tatjam/ionosphere_rx/todo.md

# Capacitor PCB

## Proof of concept

[X] ArduinoISP programmer breadboard tool
[ ] FSK generator tool (on the STM32 device for fast logic)
[ ] PLL demodulator
[ ] AtTiny software
    [ ] Relay driving (LEDs for demo)
    [ ] PLL demodulator RX
    [ ] DAC bitbang control 
    [ ] EEPROM? Probably simulate the EEPROM w/ a STM32 (for fast logic)
[ ] Dickson charge pump demo (at lower voltage, with BJT driver)

## Real construction

[ ] Finish designs with insights from POC
[ ] BOM review 
[ ] Pin and footprint review
[ ] Fabricate PCB
[ ] Assemble PCB

# Receiver PCB

## Proof of concept

[ ] Design amplifier in LTSpice
[ ] Implement with similar JFET and test

## Real construction

[ ] Design PCB
