tatjam/ionosphere_rx/journal/digital_10_received.png

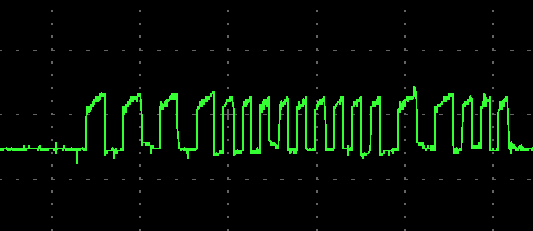
journal/digital_10_received.png
