tatjam/ionosphere_rx/hardware/capbank/capbank1.kicad_pcb

## KiCad design hardware/capbank/capbank1.kicad_pcb (2026-10-25)

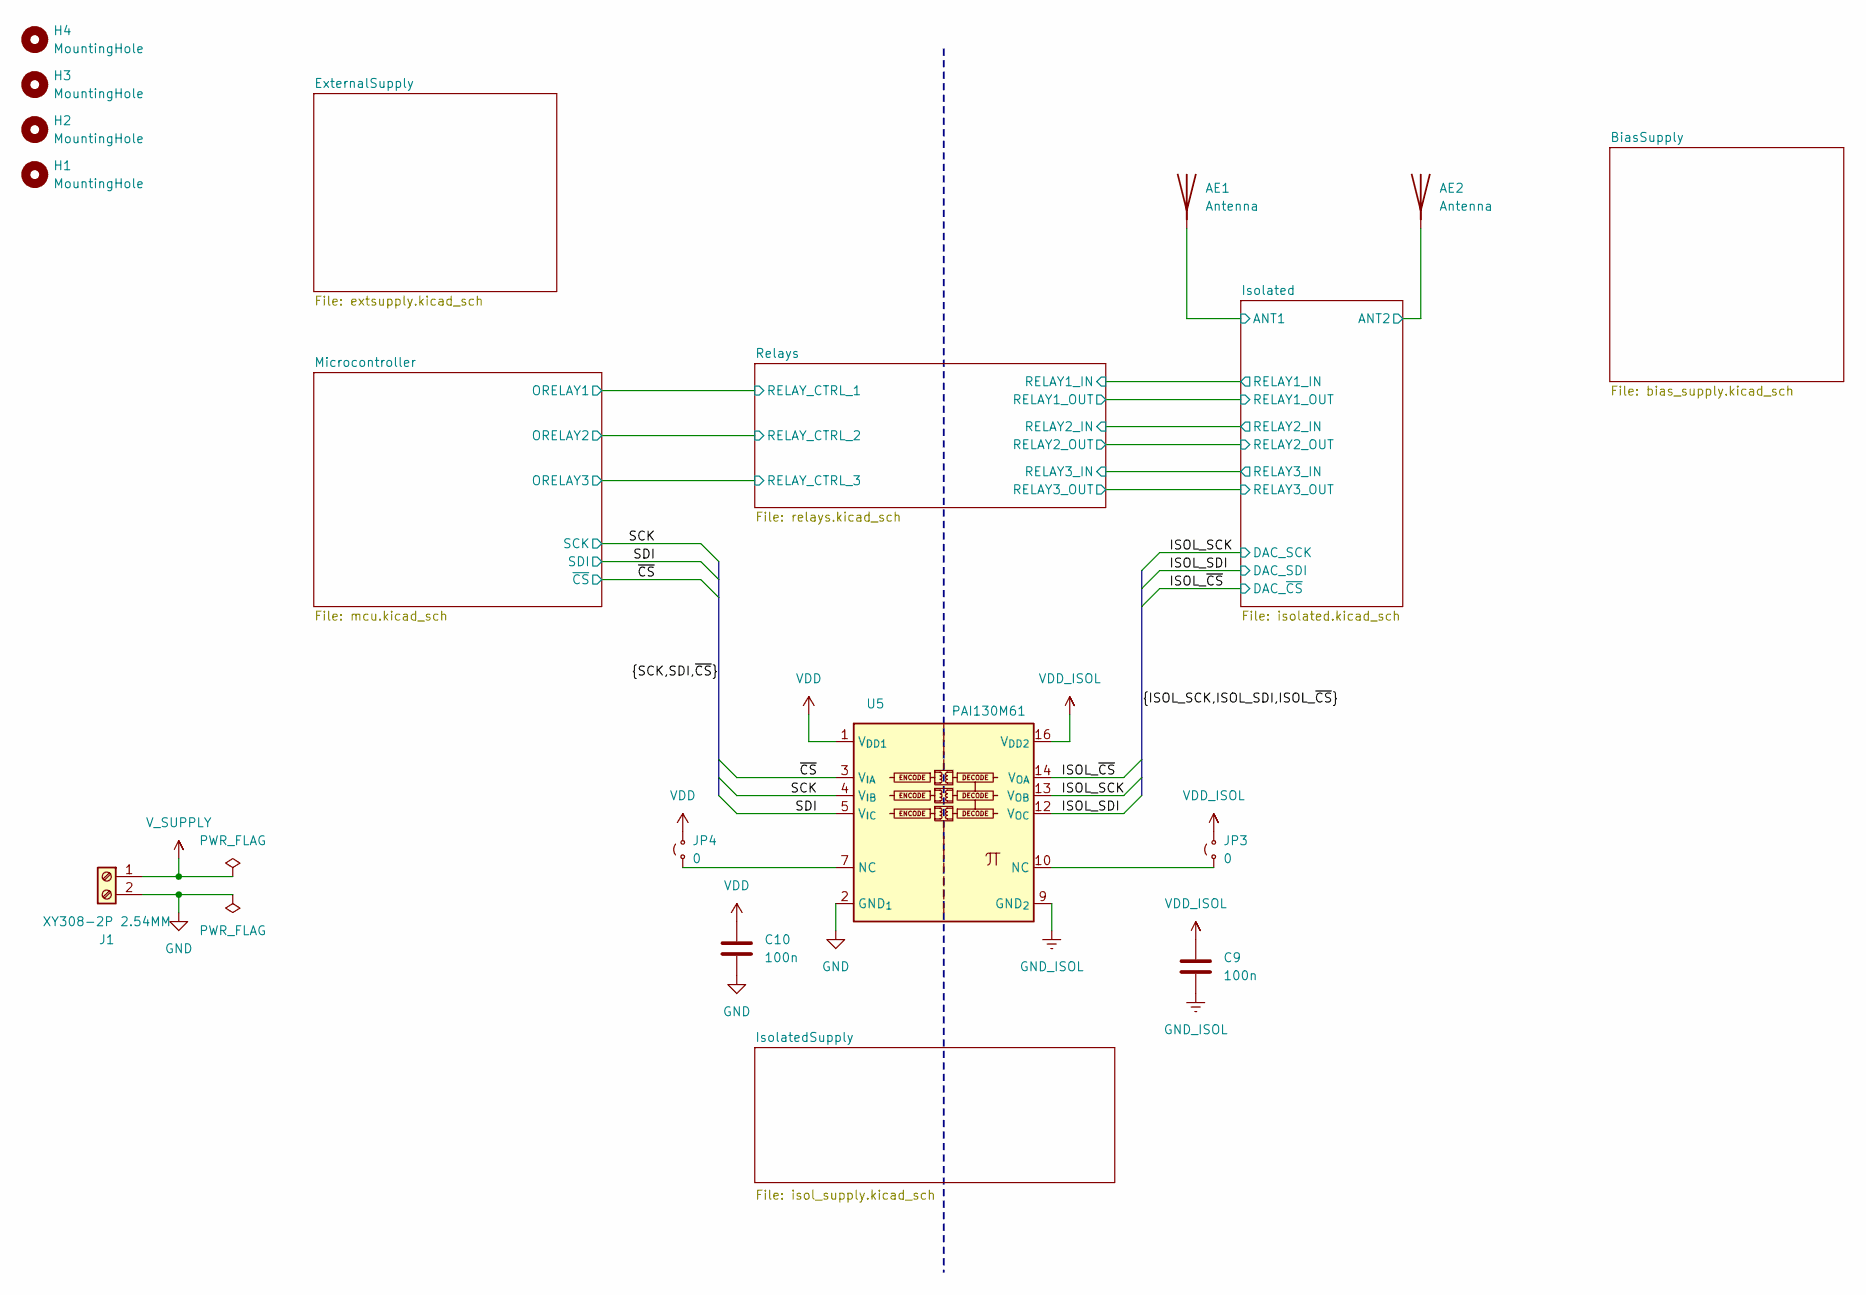
[picture p7: schematic capbank1.kicad_sch]

Parts:
AE1, AE2: Antenna; SolderWire-1.5sqmm_1x01_D1.7mm_OD3.9mm_Relief
C9, C10: 100n; C_0603_1608Metric
H1, H2, H3, H4: MountingHole; MountingHole_3.2mm_M3
J1: XY308-2P 2.54MM; TerminalBlock_Phoenix_MPT-0,5-2-2.54_1x02_P2.54mm_Horizontal
JP3, JP4: 0; R_0603_1608Metric
U5: PAI130M61; SOIC-16W_7.5x10.3mm_P1.27mm

Connections:
/ISOL_SCK: U5.13 (V_{OB}); also elsewhere on the board
/ISOL_SDI: U5.12 (V_{OC}); also elsewhere on the board
/ISOL_~CS: U5.14 (V_{OA}); also elsewhere on the board
/Isolated/ANT1: AE1.1 (A); also elsewhere on the board
/Isolated/ANT2: AE2.1 (A); also elsewhere on the board
/SCK: U5.4 (V_{IB}); also elsewhere on the board
/SDI: U5.5 (V_{IC}); also elsewhere on the board
/~CS: U5.3 (V_{IA}); also elsewhere on the board
GND: C10.2, J1.2, U5.2 (GND_{1}), U5.8 (GND_{1}); also elsewhere on the board
GND_ISOL: C9.2, U5.9 (GND_{2}), U5.15 (GND_{2}); also elsewhere on the board
unnamed: JP3.1 (A), U5.10 (NC)
unnamed: JP4.1 (A), U5.7 (NC)
VDD: C10.1, JP4.2 (B), U5.1 (V_{DD1}); also elsewhere on the board
VDD_ISOL: C9.1, JP3.2 (B), U5.16 (V_{DD2}); also elsewhere on the board
V_SUPPLY: J1.1; also elsewhere on the board

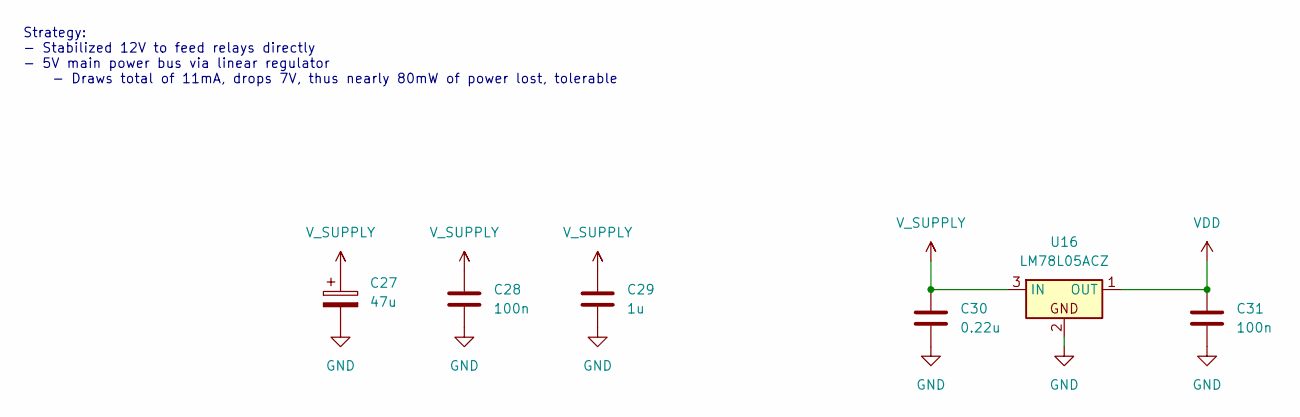
[picture p8: schematic extsupply.kicad_sch]

Parts:
C27: 47u; CP_Radial_D6.3mm_P2.50mm
C28, C31: 100n; C_0603_1608Metric
C29: 1u; C_0603_1608Metric
C30: 0.22u; C_0603_1608Metric
U16: LM78L05ACZ; TO-92_Inline_Wide

Connections:
GND: C27.2, C28.2, C29.2, C30.2, C31.2, U16.2; also elsewhere on the board
VDD: C31.1, U16.1 (OUT); also elsewhere on the board
V_SUPPLY: C27.1, C28.1, C29.1, C30.1, U16.3 (IN); also elsewhere on the board

Notes on the sheet:
Strategy: - Stabilized 12V to feed relays directly - 5V main power bus via linear regulator - Draws total of 11mA, drops 7V, thus nearly 80mW of power lost, tolerable

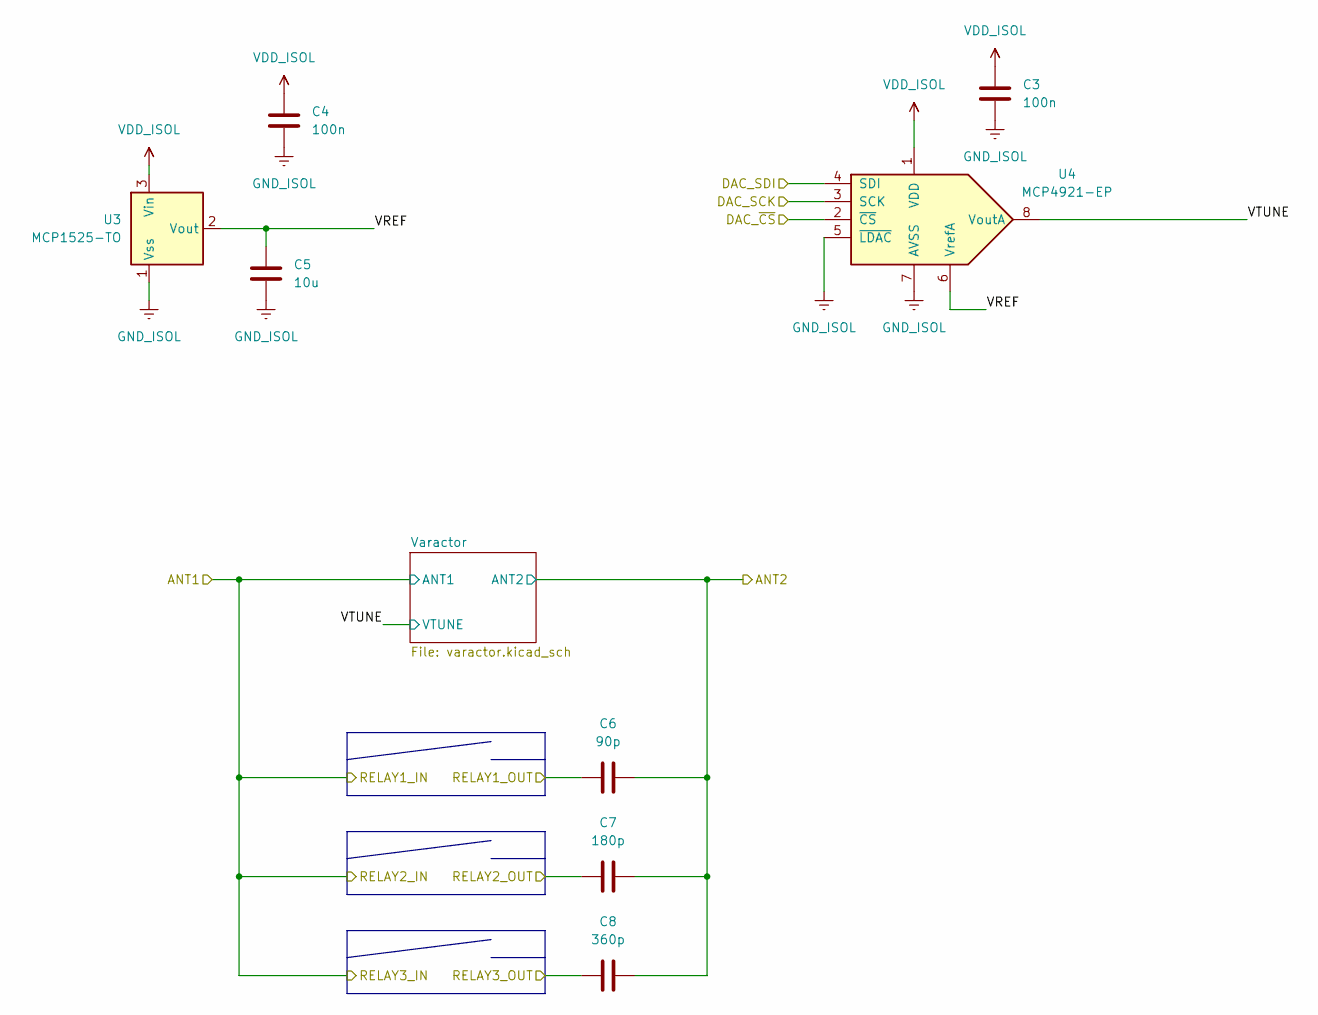
[picture p9: schematic isolated.kicad_sch]

Parts:
C3, C4: 100n; C_0603_1608Metric
C5: 10u; C_0603_1608Metric
C6: 90p; C_0603_1608Metric
C7: 180p; C_0603_1608Metric
C8: 360p; C_0603_1608Metric
U3: MCP1525-TO; TO-92_Inline
U4: MCP4921-EP; DIP-8_W7.62mm

Connections:
/ISOL_SCK: U4.3 (SCK); also elsewhere on the board
/ISOL_SDI: U4.4 (SDI); also elsewhere on the board
/ISOL_~CS: U4.2 (~CS); also elsewhere on the board
/Isolated/ANT2: C6.2, C7.2, C8.2; also elsewhere on the board
/Isolated/RELAY1_OUT: C6.1; also elsewhere on the board
/Isolated/RELAY2_OUT: C7.1; also elsewhere on the board
/Isolated/RELAY3_OUT: C8.1; also elsewhere on the board
/Isolated/VREF: C5.1, U3.2 (Vout), U4.6 (VrefA)
/Isolated/VTUNE: U4.8 (VoutA); also elsewhere on the board
GND_ISOL: C3.2, C4.2, C5.2, U3.1 (Vss), U4.5 (~LDAC), U4.7 (AVSS); also elsewhere on the board
VDD_ISOL: C3.1, C4.1, U3.3 (Vin), U4.1 (VDD); also elsewhere on the board

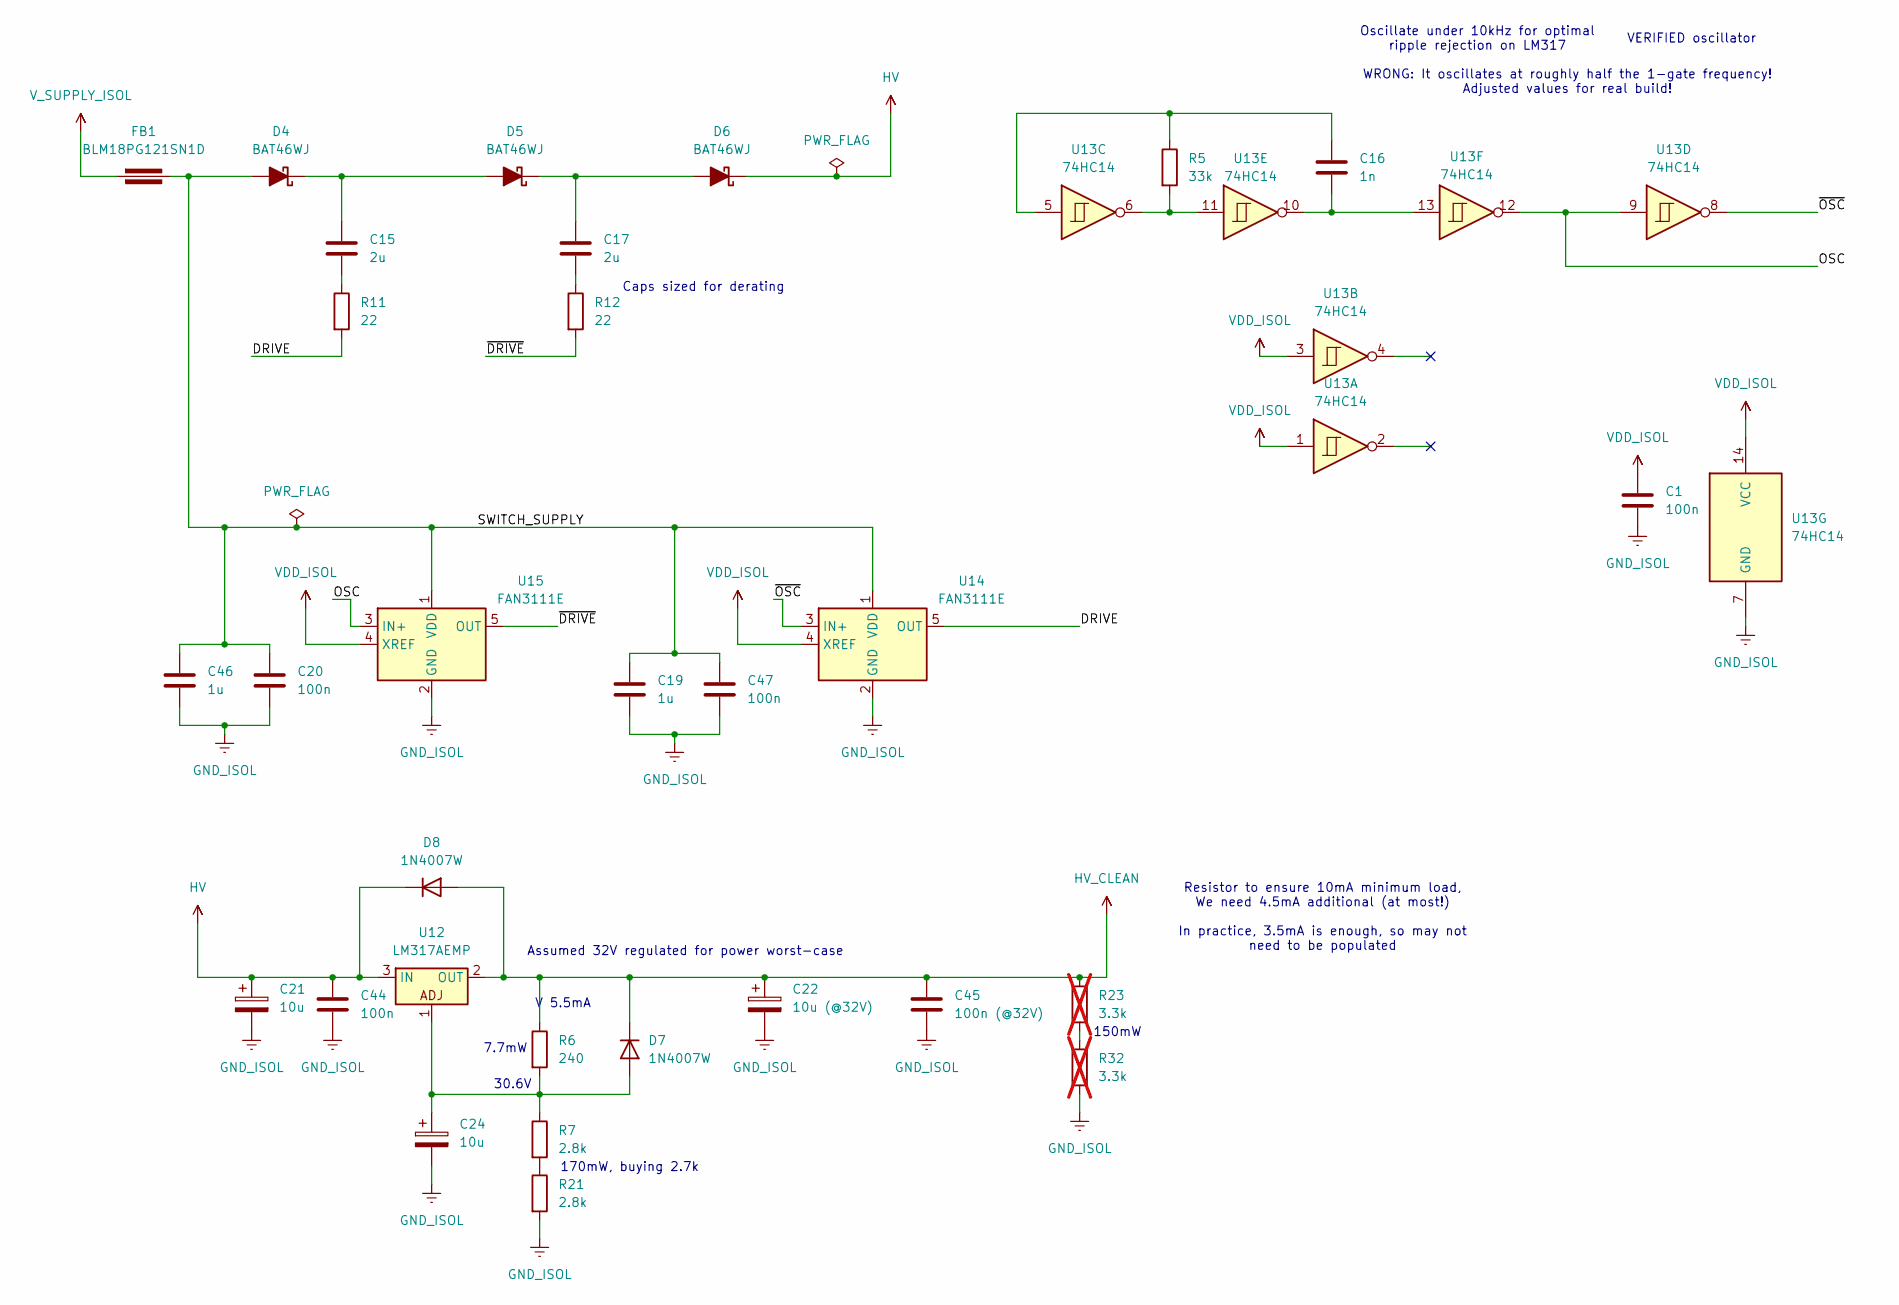
[picture p10: schematic bias_supply.kicad_sch]

Parts:
C1, C20, C44, C47: 100n; C_0603_1608Metric
C15, C17: 2u; C_0603_1608Metric
C16: 1n; C_0603_1608Metric
C19, C46: 1u; C_0603_1608Metric
C21, C24: 10u; CP_Radial_D5.0mm_P2.00mm
C22: 10u (@32V); CP_Radial_D5.0mm_P2.00mm
C45: 100n (@32V); C_0603_1608Metric
D4, D5, D6: BAT46WJ; D_SOD-323
D7, D8: 1N4007W; D_SOD-123
FB1: BLM18PG121SN1D; Ferrite_0603_1608Metric
R5: 33k; R_0603_1608Metric
R6: 240; R_0603_1608Metric
R7, R21: 2.8k; R_1206_3216Metric_Pad1.30x1.75mm_HandSolder
R11, R12: 22; R_0603_1608Metric
R23, R32: 3.3k; R_1206_3216Metric_Pad1.30x1.75mm_HandSolder; not fitted
U12: LM317AEMP; SOT-223-3_TabPin2
U13: 74HC14; SOIC-14_3.9x8.7mm_P1.27mm
U14, U15: FAN3111E; SOT-23-5

Connections:
/BiasSupply/DRIVE: R11.2, U14.5 (OUT)
/BiasSupply/OSC: U13.9, U13.12, U15.3 (IN+)
/BiasSupply/SWITCH_SUPPLY: C19.1, C20.1, C46.1, C47.1, D4.2 (A), FB1.2, U14.1 (VDD), U15.1 (VDD)
/BiasSupply/~DRIVE: R12.2, U15.5 (OUT)
/BiasSupply/~OSC: U13.8, U14.3 (IN+)
GND_ISOL: C1.2, C19.2, C20.2, C21.2, C22.2, C24.2, C44.2, C45.2, C46.2, C47.2, R21.2, R32.2, U13.7 (GND), U14.2 (GND), U15.2 (GND); also elsewhere on the board
HV: C21.1, C44.1, D6.1 (K), D8.1 (K), U12.3 (IN)
HV_CLEAN: C22.1, C45.1, D7.1 (K), D8.2 (A), R6.1, R23.1, U12.2 (OUT); also elsewhere on the board
unnamed: C15.2, R11.1
unnamed: C16.1, R5.1, U13.5
unnamed: C16.2, U13.10, U13.13
unnamed: C17.2, R12.1
unnamed: C15.1, D4.1 (K), D5.2 (A)
unnamed: C17.1, D5.1 (K), D6.2 (A)
unnamed: C24.1, D7.2 (A), R6.2, R7.1, U12.1
unnamed: R5.2, U13.6, U13.11
unnamed: R7.2, R21.1
unnamed: R23.2, R32.1
VDD_ISOL: C1.1, U13.1, U13.3, U13.14 (VCC), U14.4 (XREF), U15.4 (XREF); also elsewhere on the board
V_SUPPLY_ISOL: FB1.1; also elsewhere on the board

Notes on the sheet:
WRONG: It oscillates at roughly half the 1-gate frequency! Adjusted values for real build!
VERIFIED oscillator
30.6V
150mW
Oscillate under 10kHz for optimal ripple rejection on LM317
Assumed 32V regulated for power worst-case
7.7mW
Resistor to ensure 10mA minimum load, We need 4.5mA additional (at most!) In practice, 3.5mA is enough, so may not need to be populated
170mW, buying 2.7k
V 5.5mA
Caps sized for derating

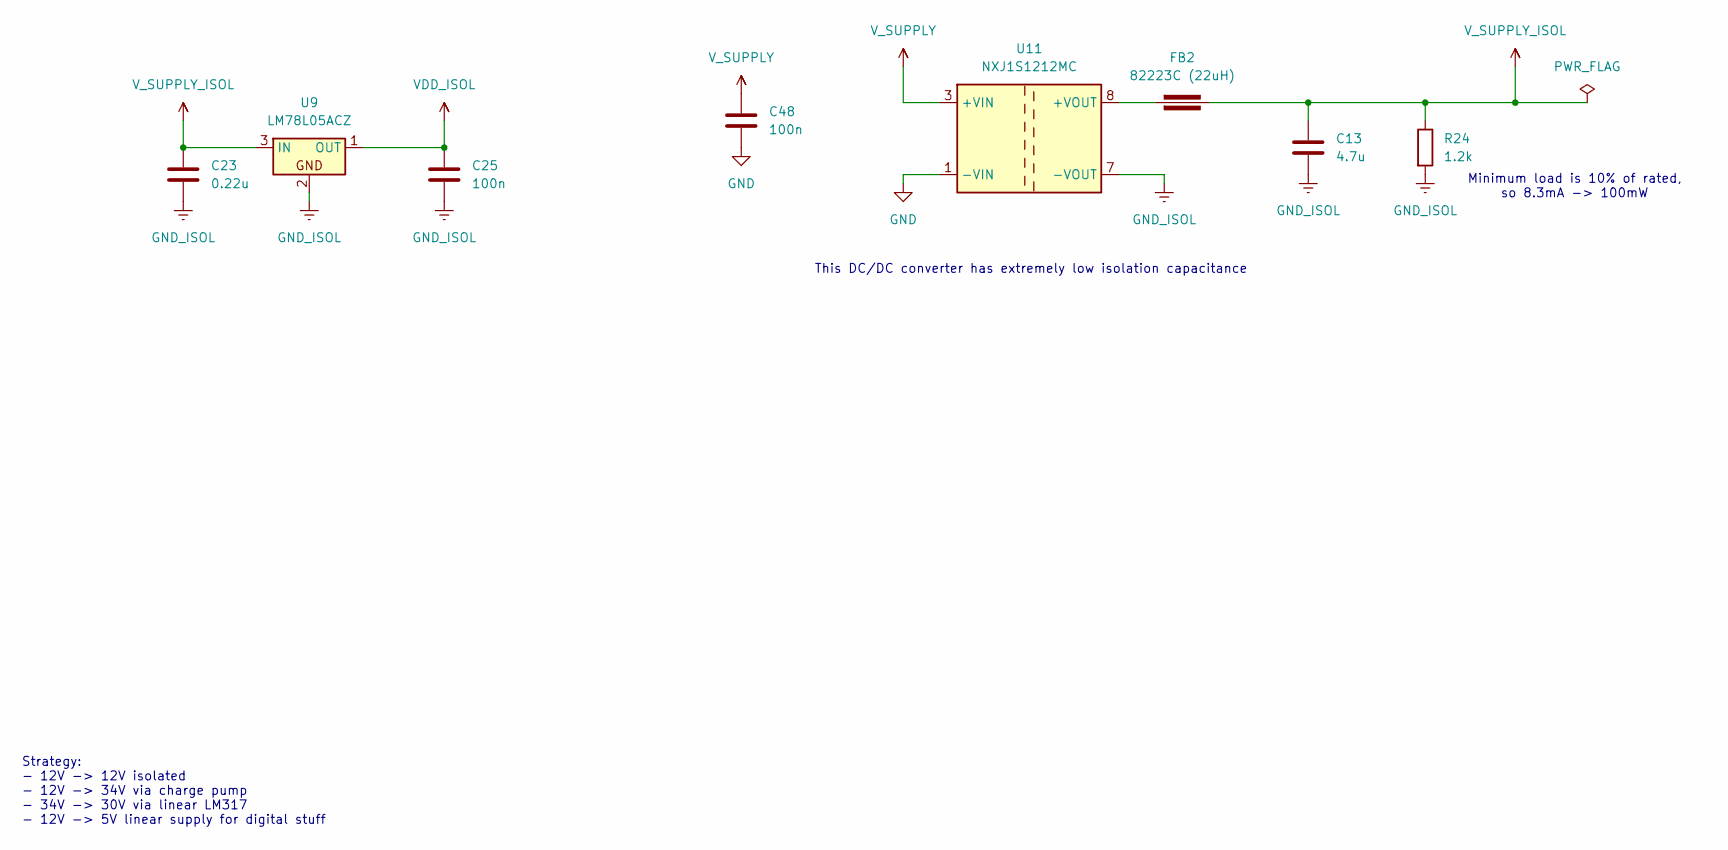
[picture p11: schematic isol_supply.kicad_sch]

Parts:
C13: 4.7u; C_1210_3225Metric_Pad1.33x2.70mm_HandSolder
C23: 0.22u; C_0603_1608Metric
C25, C48: 100n; C_0603_1608Metric
FB2: 82223C (22uH); 82223C
R24: 1.2k; R_1206_3216Metric_Pad1.30x1.75mm_HandSolder
U9: LM78L05ACZ; TO-92_Inline_Wide
U11: NXJ1S1212MC; NXJ1

Connections:
GND: C48.2, U11.1 (-VIN); also elsewhere on the board
GND_ISOL: C13.2, C23.2, C25.2, R24.2, U9.2, U11.7 (-VOUT); also elsewhere on the board
unnamed: FB2.1, U11.8 (+VOUT)
VDD_ISOL: C25.1, U9.1 (OUT); also elsewhere on the board
V_SUPPLY: C48.1, U11.3 (+VIN); also elsewhere on the board
V_SUPPLY_ISOL: C13.1, C23.1, FB2.2, R24.1, U9.3 (IN); also elsewhere on the board

Notes on the sheet:
Strategy: - 12V -> 12V isolated - 12V -> 34V via charge pump - 34V -> 30V via linear LM317 - 12V -> 5V linear supply for digital stuff
Minimum load is 10% of rated, so 8.3mA -> 100mW
This DC/DC converter has extremely low isolation capacitance

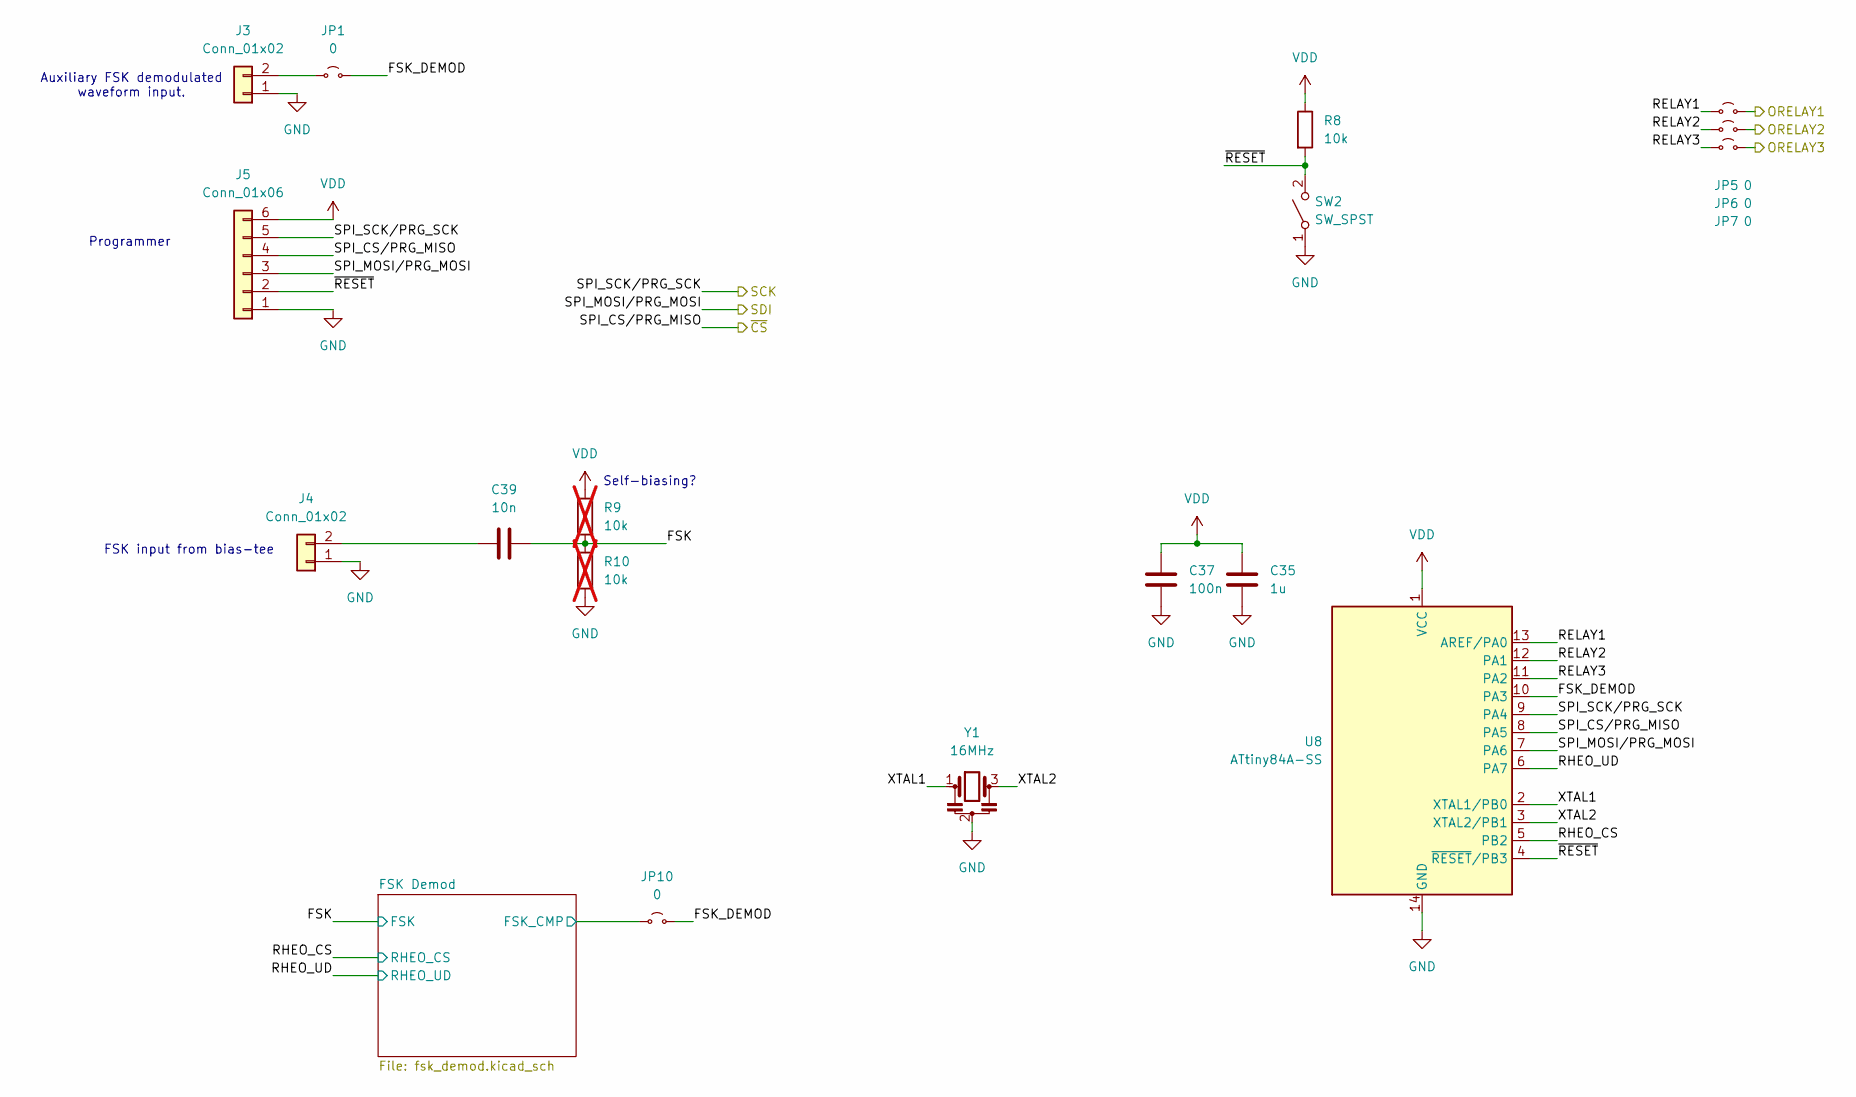
[picture p12: schematic mcu.kicad_sch]

Parts:
C35: 1u; C_0603_1608Metric
C37: 100n; C_0603_1608Metric
C39: 10n; C_0603_1608Metric
J3, J4: Conn_01x02; PinHeader_1x02_P2.54mm_Vertical
J5: Conn_01x06
JP1, JP5, JP6, JP7, JP10: 0; R_0603_1608Metric
R8: 10k; R_0603_1608Metric
R9, R10: 10k; R_0603_1608Metric; not fitted
SW2: SW_SPST; SW_SPST_CK_KXT3
U8: ATtiny84A-SS; SOIC-14_3.9x8.7mm_P1.27mm
Y1: 16MHz; Resonator_SMD_muRata_CSTxExxV-3Pin_3.0x1.1mm_BigPads

Connections:
/Microcontroller/FSK: C39.2, R9.2, R10.1; also elsewhere on the board
/Microcontroller/FSK Demod/FSK_CMP: JP10.1 (A); also elsewhere on the board
/Microcontroller/FSK_DEMOD: JP1.2 (B), JP10.2 (B), U8.10 (PA3)
/Microcontroller/ORELAY1: JP5.2 (B); also elsewhere on the board
/Microcontroller/ORELAY2: JP6.2 (B); also elsewhere on the board
/Microcontroller/ORELAY3: JP7.2 (B); also elsewhere on the board
/Microcontroller/RELAY1: JP5.1 (A), U8.13 (AREF/PA0)
/Microcontroller/RELAY2: JP6.1 (A), U8.12 (PA1)
/Microcontroller/RELAY3: JP7.1 (A), U8.11 (PA2)
/Microcontroller/RHEO_CS: U8.5 (PB2); also elsewhere on the board
/Microcontroller/RHEO_UD: U8.6 (PA7); also elsewhere on the board
/Microcontroller/XTAL1: U8.2 (XTAL1/PB0), Y1.1
/Microcontroller/XTAL2: U8.3 (XTAL2/PB1), Y1.3
/Microcontroller/~RESET: J5.2, R8.2, SW2.2 (B), U8.4 (~RESET/PB3)
/SCK: J5.5, U8.9 (PA4); also elsewhere on the board
/SDI: J5.3, U8.7 (PA6); also elsewhere on the board
/~CS: J5.4, U8.8 (PA5); also elsewhere on the board
GND: C35.2, C37.2, J3.1, J4.1, J5.1, R10.2, SW2.1 (A), U8.14 (GND), Y1.2; also elsewhere on the board
unnamed: J3.2, JP1.1 (A)
unnamed: C39.1, J4.2
VDD: C35.1, C37.1, J5.6, R8.1, R9.1, U8.1 (VCC); also elsewhere on the board

Notes on the sheet:
Programmer
Auxiliary FSK demodulated waveform input.
Self-biasing?
FSK input from bias-tee

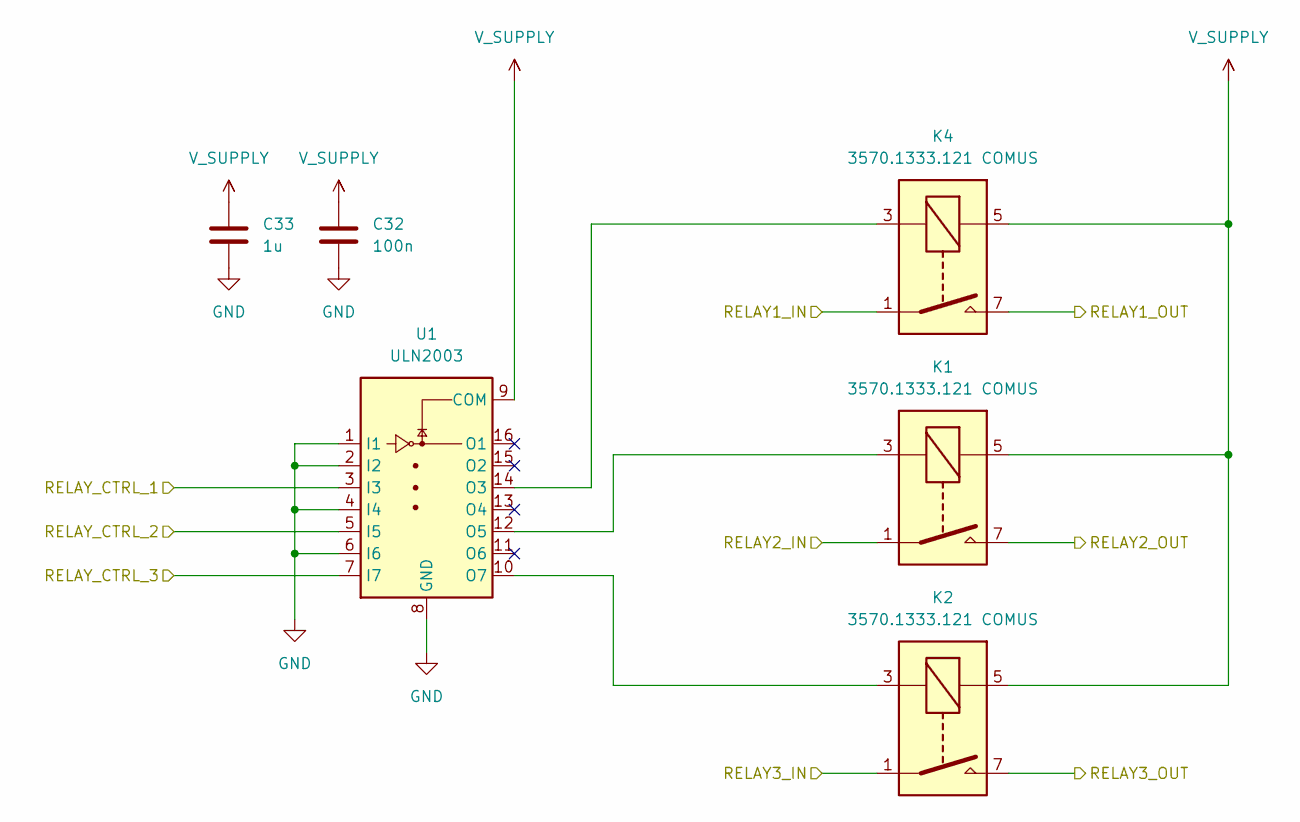
[picture p13: schematic relays.kicad_sch]

Parts:
C32: 100n; C_0603_1608Metric
C33: 1u; C_0603_1608Metric
K1, K2, K4: 3570.1333.121 COMUS; Relay_SPST_StandexMeder_SIL_Form1A
U1: ULN2003; SOIC-16_3.9x9.9mm_P1.27mm

Connections:
/Isolated/ANT1: K1.1, K2.1, K4.1; also elsewhere on the board
/Isolated/RELAY1_OUT: K4.7; also elsewhere on the board
/Isolated/RELAY2_OUT: K1.7; also elsewhere on the board
/Isolated/RELAY3_OUT: K2.7; also elsewhere on the board
/Microcontroller/ORELAY1: U1.3 (I3); also elsewhere on the board
/Microcontroller/ORELAY2: U1.5 (I5); also elsewhere on the board
/Microcontroller/ORELAY3: U1.7 (I7); also elsewhere on the board
GND: C32.2, C33.2, U1.1 (I1), U1.2 (I2), U1.4 (I4), U1.6 (I6), U1.8 (GND); also elsewhere on the board
unnamed: K4.3, U1.14 (O3)
unnamed: K1.3, U1.12 (O5)
unnamed: K2.3, U1.10 (O7)
V_SUPPLY: C32.1, C33.1, K1.5, K2.5, K4.5, U1.9 (COM); also elsewhere on the board

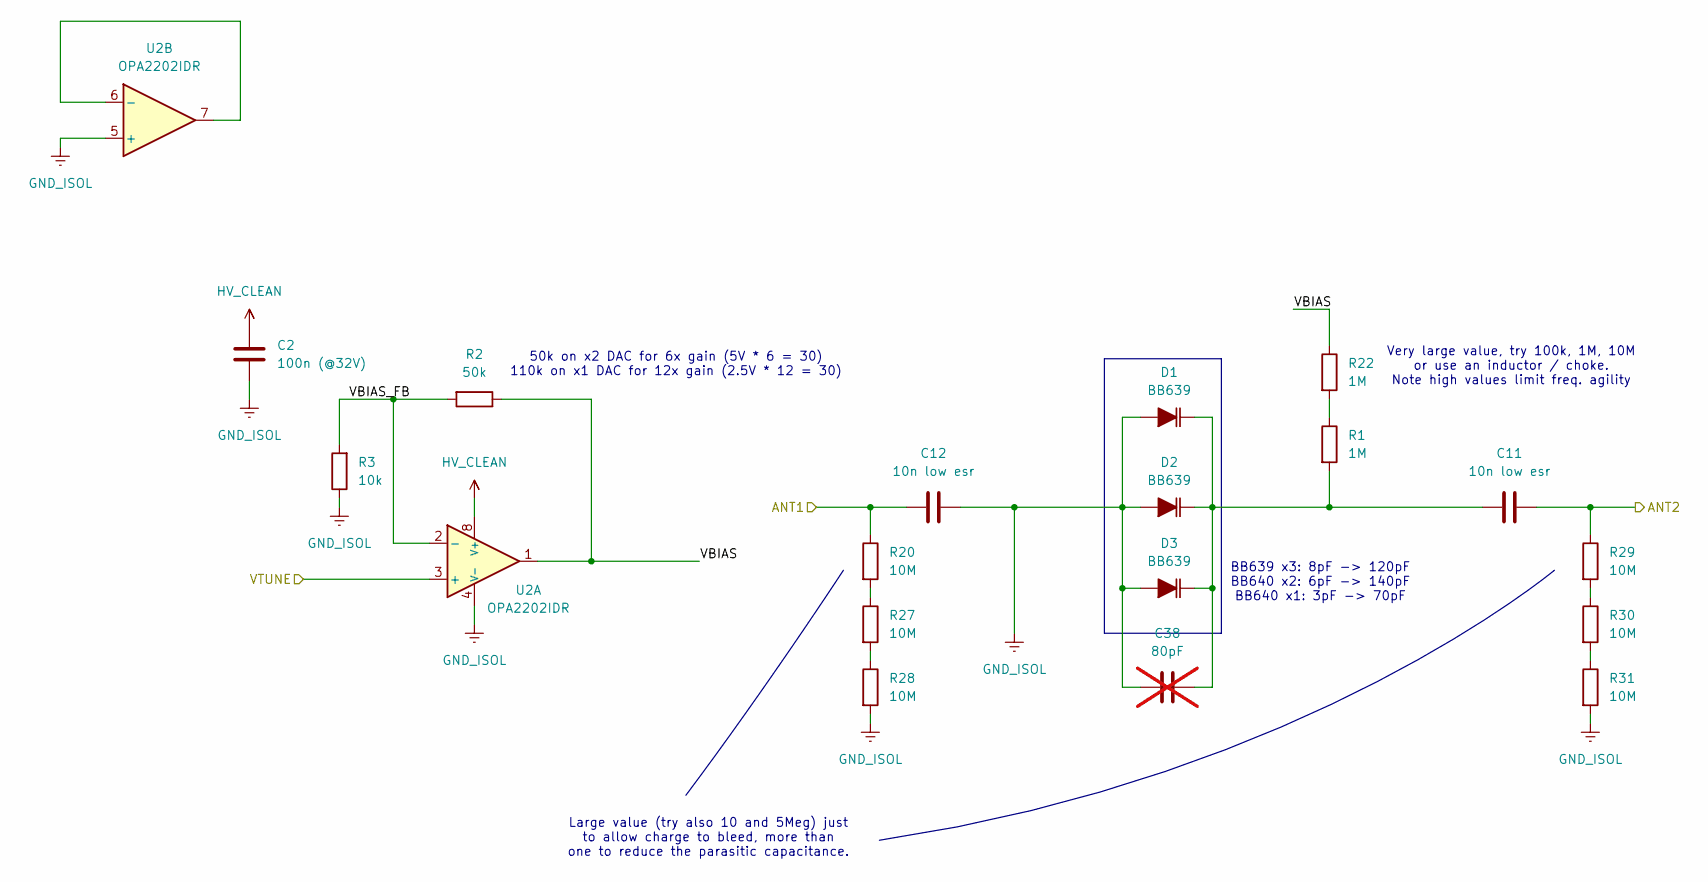
[picture p14: schematic varactor.kicad_sch]

Parts:
C2: 100n (@32V); C_0603_1608Metric
C11, C12: 10n low esr; C_1206_3216Metric
C38: 80pF; C_0603_1608Metric; not fitted
D1, D2, D3: BB639; D_SOD-323
R1, R22: 1M; R_0603_1608Metric
R2: 50k; R_0603_1608Metric
R3: 10k; R_0603_1608Metric
R20, R27, R28, R29, R30, R31: 10M; R_0603_1608Metric
U2: OPA2202IDR; SOIC-8_3.9x4.9mm_P1.27mm

Connections:
/Isolated/ANT1: C12.1, R20.1; also elsewhere on the board
/Isolated/ANT2: C11.2, R29.1; also elsewhere on the board
/Isolated/VTUNE: U2.3 (+); also elsewhere on the board
/Isolated/Varactor/VBIAS: R2.1, R22.1, U2.1
/Isolated/Varactor/VBIAS_FB: R2.2, R3.2, U2.2 (-)
GND_ISOL: C2.2, C12.2, C38.1, D1.2 (A), D2.2 (A), D3.2 (A), R3.1, R28.2, R31.2, U2.4 (V-), U2.5 (+); also elsewhere on the board
HV_CLEAN: C2.1, U2.8 (V+); also elsewhere on the board
unnamed: C11.1, C38.2, D1.1 (K), D2.1 (K), D3.1 (K), R1.2
unnamed: R1.1, R22.2
unnamed: R20.2, R27.1
unnamed: R27.2, R28.1
unnamed: R29.2, R30.1
unnamed: R30.2, R31.1
unnamed: U2.6 (-), U2.7

Notes on the sheet:
Large value (try also 10 and 5Meg) just to allow charge to bleed, more than one to reduce the parasitic capacitance.
50k on x2 DAC for 6x gain (5V * 6 = 30) 110k on x1 DAC for 12x gain (2.5V * 12 = 30)
BB639 x3: 8pF -> 120pF BB640 x2: 6pF -> 140pF BB640 x1: 3pF -> 70pF
Very large value, try 100k, 1M, 10M or use an inductor / choke. Note high values limit freq. agility

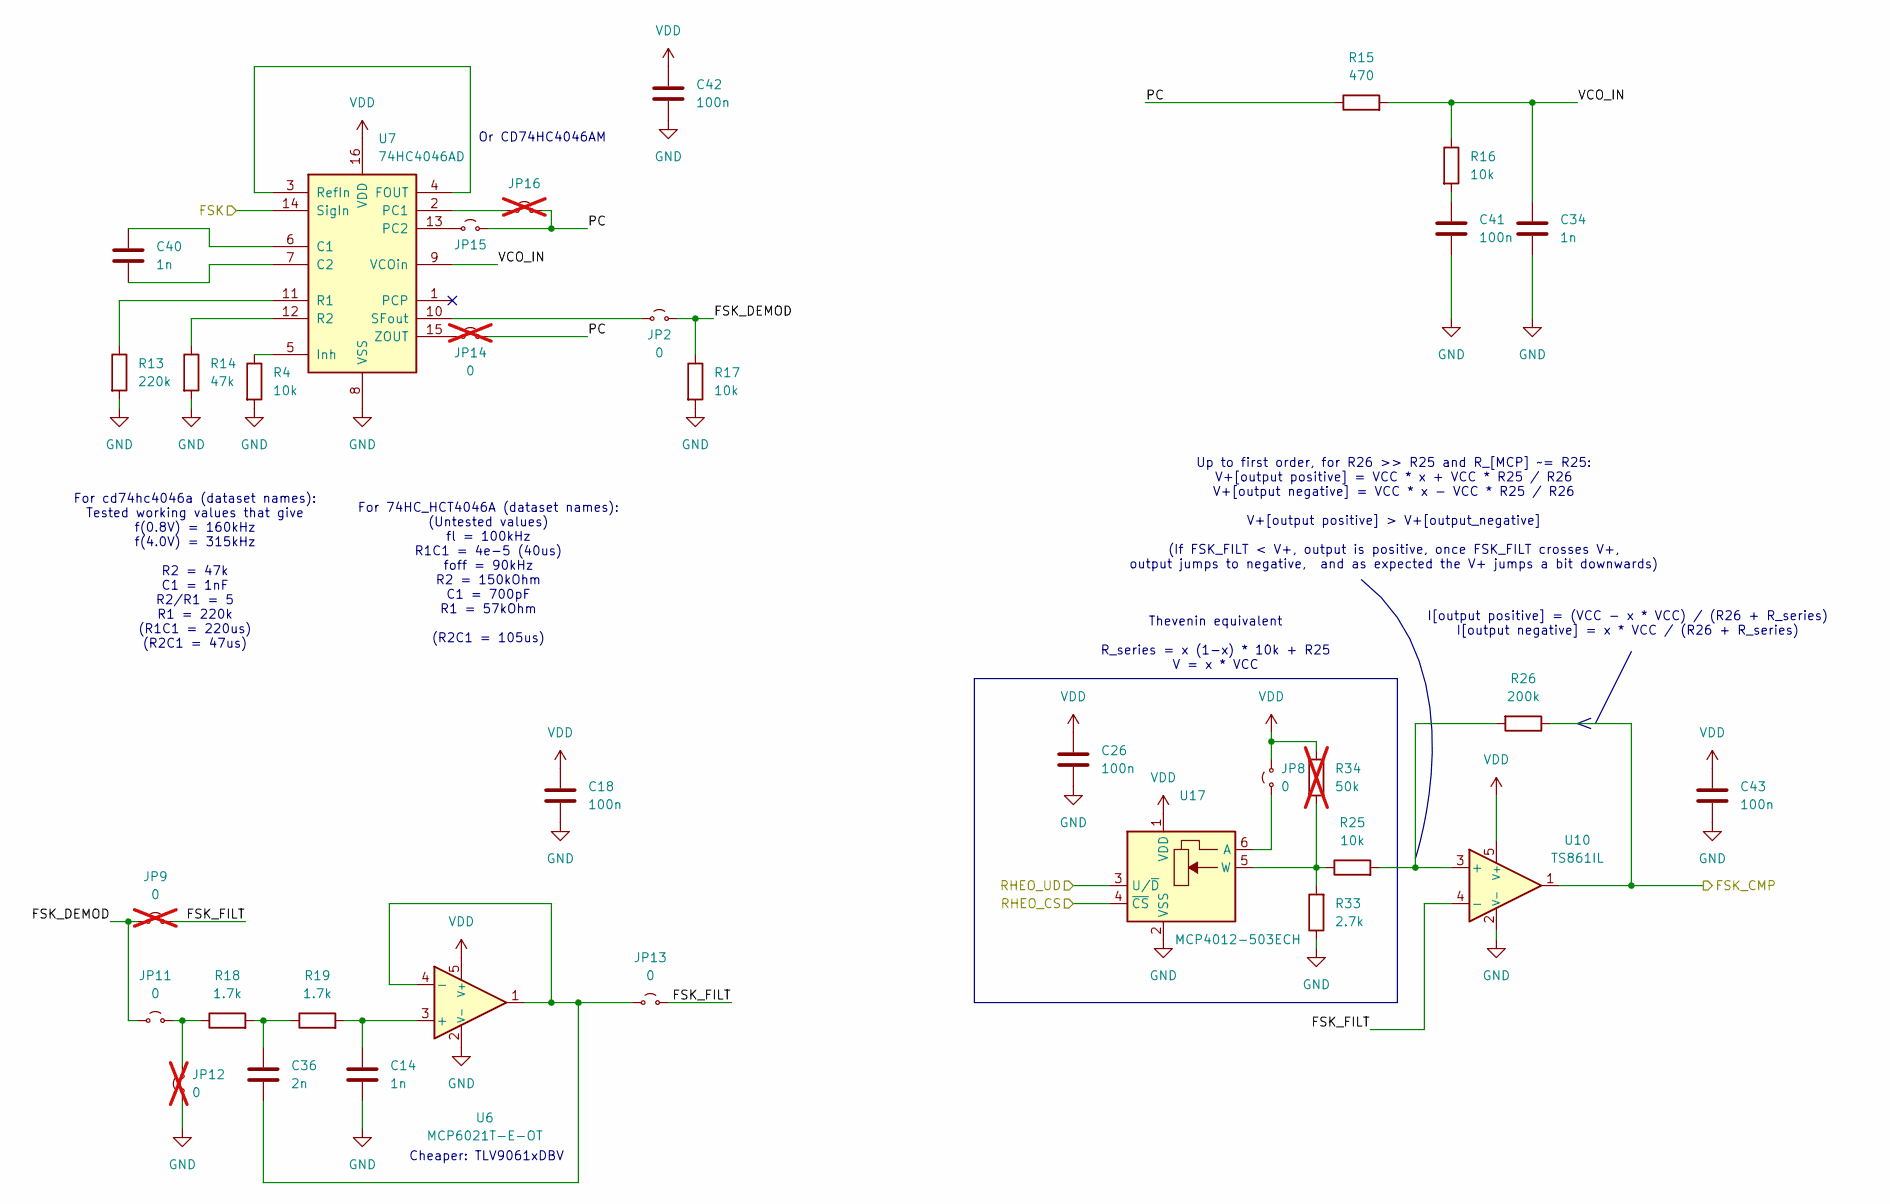
[picture p15: schematic fsk_demod.kicad_sch]

Parts:
C14, C34, C40: 1n; C_0603_1608Metric
C18, C26, C41, C42, C43: 100n; C_0603_1608Metric
C36: 2n; C_0603_1608Metric
JP2, JP8, JP11, JP13, JP15: 0; R_0603_1608Metric
JP9, JP12, JP14, JP16: 0; R_0603_1608Metric; not fitted
R4, R16, R17, R25: 10k; R_0603_1608Metric
R13: 220k; R_0603_1608Metric
R14: 47k; R_0603_1608Metric
R15: 470; R_0603_1608Metric
R18, R19: 1.7k; R_0603_1608Metric
R26: 200k; R_0603_1608Metric
R33: 2.7k; R_0603_1608Metric
R34: 50k; R_0603_1608Metric; not fitted
U6: MCP6021T-E-OT; SOT-23-5
U7: 74HC4046AD; SOIC-16_3.9x9.9mm_P1.27mm
U10: TS861IL; SOT-23-5
U17: MCP4012-503ECH; SOT-23-6

Connections:
/Microcontroller/FSK: U7.14 (SigIn); also elsewhere on the board
/Microcontroller/FSK Demod/FSK_CMP: R26.1, U10.1; also elsewhere on the board
/Microcontroller/FSK Demod/FSK_DEMOD: JP2.2 (B), JP9.1 (A), JP11.1 (A), R17.1
/Microcontroller/FSK Demod/FSK_FILT: JP9.2 (B), JP13.2 (B), U10.4 (-)
/Microcontroller/FSK Demod/PC: JP14.2 (B), JP15.2 (B), JP16.2 (B), R15.1
/Microcontroller/FSK Demod/VCO_IN: C34.1, R15.2, R16.1, U7.9 (VCOin)
/Microcontroller/RHEO_CS: U17.4 (~CS); also elsewhere on the board
/Microcontroller/RHEO_UD: U17.3 (U/~D); also elsewhere on the board
GND: C14.2, C18.2, C26.2, C34.2, C41.2, C42.2, C43.2, JP12.1 (A), R4.2, R13.2, R14.2, R17.2, R33.1, U6.2 (V-), U7.8 (VSS), U10.2 (V-), U17.2 (VSS); also elsewhere on the board
unnamed: C36.1, R18.2, R19.1
unnamed: C41.1, R16.2
unnamed: JP2.1 (A), U7.10 (SFout)
unnamed: JP8.1 (A), U17.6 (A)
unnamed: JP11.2 (B), JP12.2 (B), R18.1
unnamed: C36.2, JP13.1 (A), U6.1, U6.4 (-)
unnamed: JP14.1 (A), U7.15 (ZOUT)
unnamed: JP15.1 (A), U7.13 (PC2)
unnamed: JP16.1 (A), U7.2 (PC1)
unnamed: C14.1, R19.2, U6.3 (+)
unnamed: C40.1, U7.6 (C1)
unnamed: C40.2, U7.7 (C2)
unnamed: U7.3 (RefIn), U7.4 (FOUT)
unnamed: R4.1, U7.5 (Inh)
unnamed: R13.1, U7.11 (R1)
unnamed: R14.1, U7.12 (R2)
unnamed: R25.2, R26.2, U10.3 (+)
unnamed: R25.1, R33.2, R34.1, U17.5 (W)
VDD: C18.1, C26.1, C42.1, C43.1, JP8.2 (B), R34.2, U6.5 (V+), U7.16 (VDD), U10.5 (V+), U17.1 (VDD); also elsewhere on the board

Notes on the sheet:
Cheaper: TLV9061xDBV
I[output positive] = (VCC - x * VCC) / (R26 + R_series) I[output negative] = x * VCC / (R26 + R_series)
Up to first order, for R26 >> R25 and R_[MCP] ~= R25: V+[output positive] = VCC * x + VCC * R25 / R26 V+[output negative] = VCC * x - VCC * R25 / R26 V+[output positive] > V+[output_negative] (If FSK_FILT < V+, output is positive, once FSK_FILT crosses V+, output jumps to negative, and as expected 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
Or CD74HC4046AM
For cd74hc4046a (dataset names): Tested working values that give f(0.8V) = 160kHz f(4.0V) = 315kHz R2 = 47k C1 = 1nF R2/R1 = 5 R1 = 220k (R1C1 = 220us) (R2C1 = 47us)
For 74HC_HCT4046A (dataset names): (Untested values) fl = 100kHz R1C1 = 4e-5 (40us) foff = 90kHz R2 = 150kOhm C1 = 700pF R1 = 57kOhm (R2C1 = 105us)
Thevenin equivalent R_series = x (1-x) * 10k + R25 V = x * VCC
