tatjam/ionosphere_rx/hardware/capbank/capbank1.kicad_pcb

## KiCad design hardware/capbank/capbank1.kicad_pcb (continued)

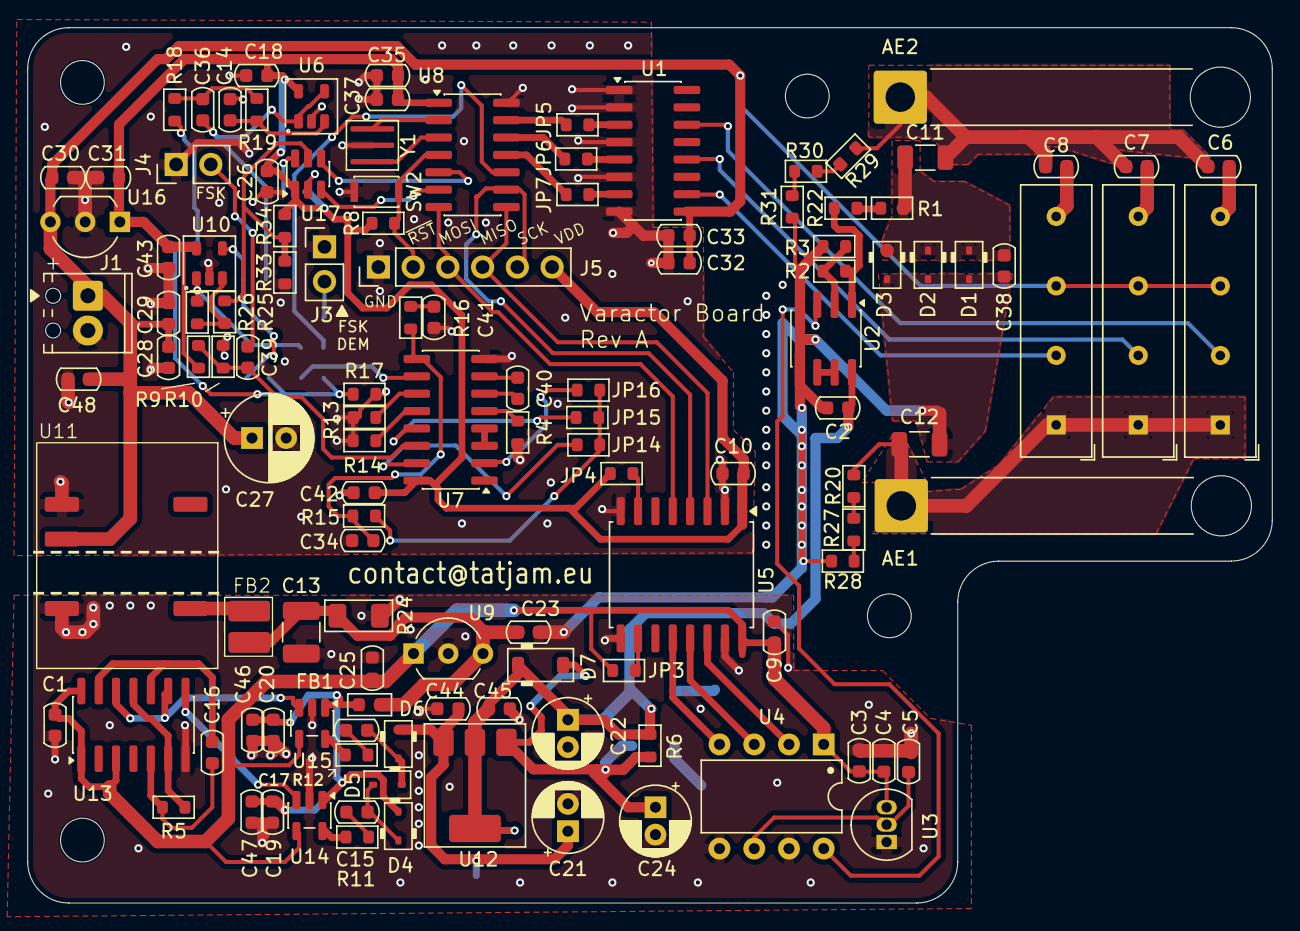
[picture p16: board capbank1.kicad_pcb from above]

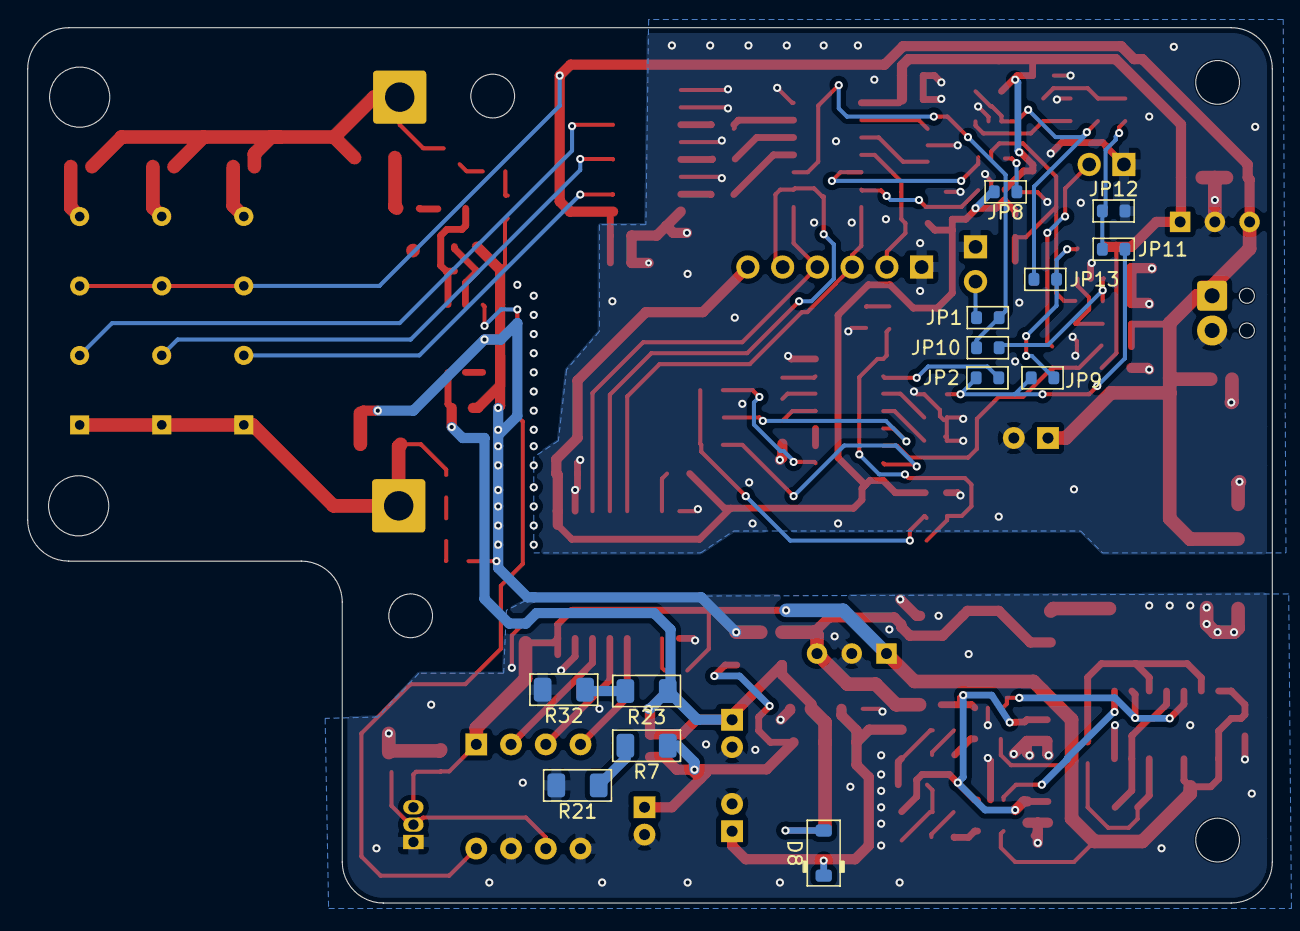
[picture p17: board capbank1.kicad_pcb from below]

Board: 2 copper layers, 91.0 x 64.0 mm, 140 parts (13 on the bottom side), 89 nets.
