tatjam/ionosphere_rx/firmware/pc_interface/uart.h

// Copyright (C) 2026 tatjam
// SPDX-License-Identifier: GPL-3.0-or-later
#pragma once

#include <stdint.h>
#define UART_BAUD 250000

void uart_init();
void uart_tx(uint8_t data);
void uart_tx_cstr(const char *str);
uint8_t uart_get_next_count();
uint8_t uart_read_next();
