tatjam/ionosphere_rx/firmware/dac_spi.h

// Copyright (C) 2026 tatjam
// SPDX-License-Identifier: GPL-3.0-or-later

#pragma once
#include <avr/io.h>
#include <stdint.h>

#define DAC_SPI_PIN_SDI	 PA7
#define DAC_SPI_PORT_SDI PORTA
#define DAC_SPI_DDR_SDI	 DDRA

#define DAC_SPI_PIN_SCK	 PB2
#define DAC_SPI_PORT_SCK PORTB
#define DAC_SPI_DDR_SCK	 DDRB

#define DAC_SPI_PIN_CS	PA5
#define DAC_SPI_PORT_CS PORTA
#define DAC_SPI_DDR_CS	DDRA

void dac_spi_init();
void dac_spi_send(uint16_t value);
