tatjam/ionosphere_rx/serial/utils.py

def fletcher16(data):
    s1 = s2 = 0
    for b in data:
        s1 = (s1 + b) % 255
        s2 = (s2 + s1) % 255
    return s1 | (s2 << 8)


def cobs(data):
    out = bytearray([0])
    code_pos, code = 0, 1
    for b in data:
        if b == 0:
            out[code_pos] = code
            code_pos, code = len(out), 1
            out.append(0)
        else:
            out.append(b)
            code += 1
    out[code_pos] = code
    return bytes(out)


def u16(v):
    return bytes([v & 0xFF, (v >> 8) & 0xFF])


def u32(v):
    return bytes([v & 0xFF, (v >> 8) & 0xFF, (v >> 16) & 0xFF, (v >> 24) & 0xFF])
