tatjam/ionosphere_rx/(commit log)

2026-04-17 Initial SPI DAC
2026-04-17 Small fixes and added "debug" LED back
2026-04-19 KiCad changes
2026-07-29 Add footprint for buffered-filter and replace pot with digital pot
2026-08-01 Update PCB with learned lessons
2026-08-02 Simulate the output filter, it appears workable
2026-08-02 Various wiring fixes and add bleed resistor to antenna
2026-09-20 Small changes after building the PCB
2026-09-20 Fix relays wrong pin used
2026-10-17 Basic ring buffer as its logic is needed both in manchester and the uart buffer
2026-10-17 Initial UART for the pc interface
2026-10-17 Initial port of Arduino ISP programmer
2026-10-18 Fix small issues on UART due to arduino bootloader
2026-10-25 Calibration, needs refactor but works!!
2026-10-25 Kicad Update
